bueche/boat_drone/doc/images/boat_scaled_to_accomodate_electronics.jpg

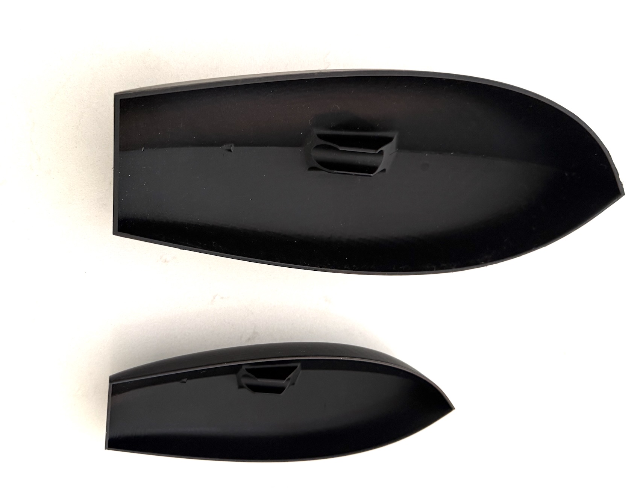
doc/images/boat_scaled_to_accomodate_electronics.jpg
