bueche/boat_drone/doc/images/esp32.3pack.jpg

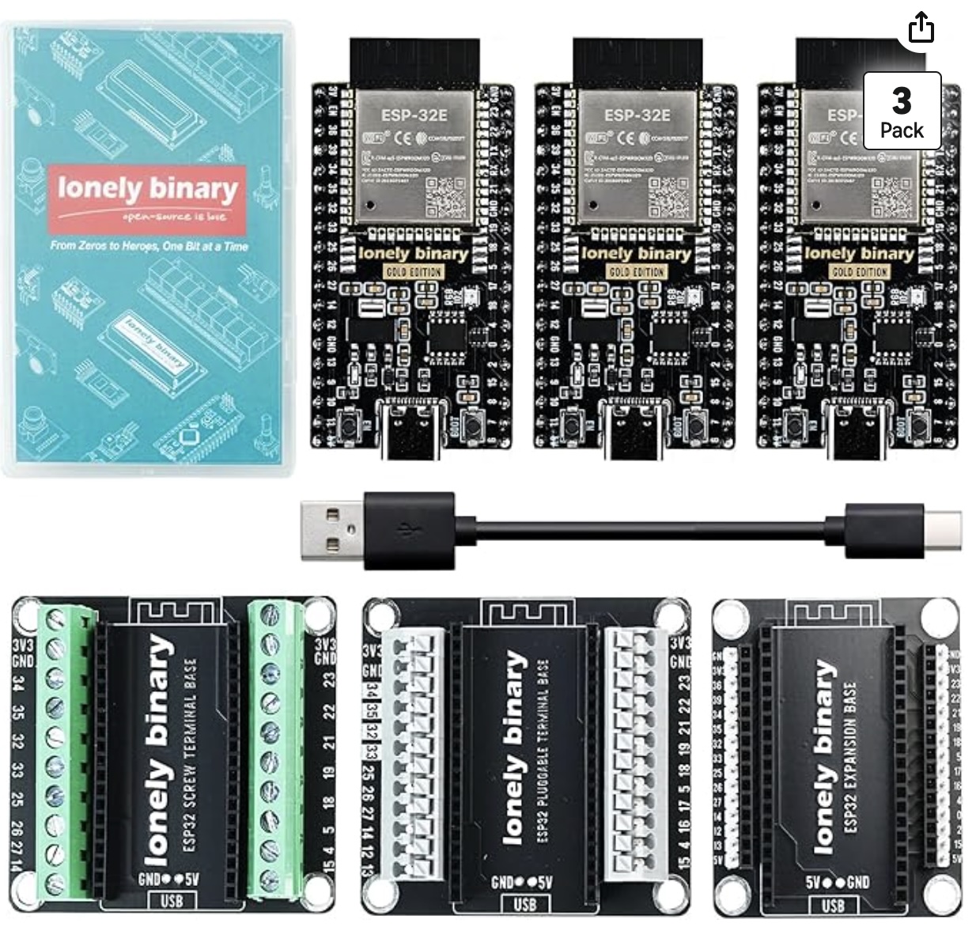
doc/images/esp32.3pack.jpg
