bueche/boat_drone/doc/images/mounting-motor.jpeg

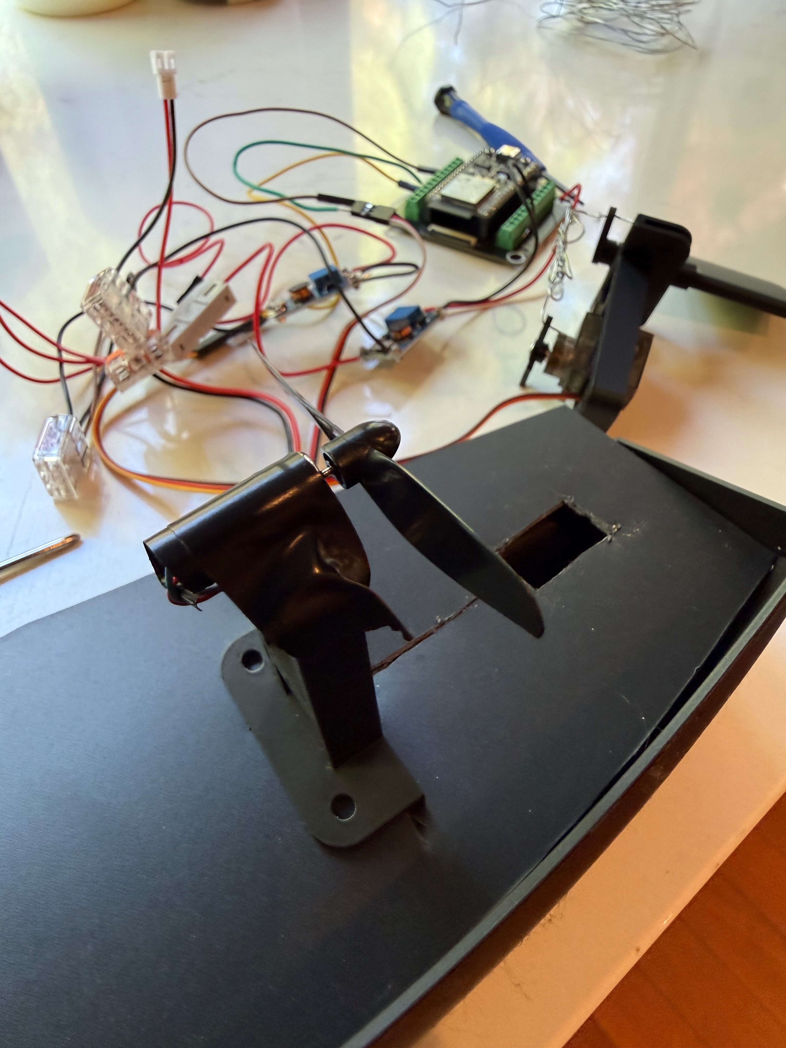
doc/images/mounting-motor.jpeg
