bueche/boat_drone/doc/images/multi-meter1.jpeg

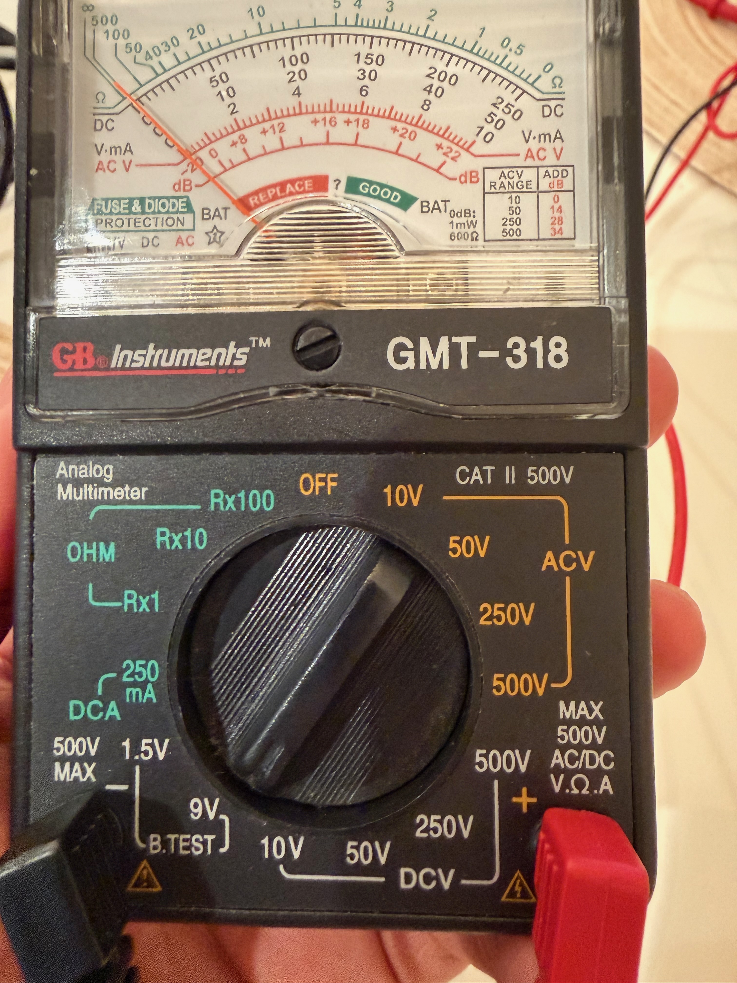
doc/images/multi-meter1.jpeg
