bueche/boat_drone/doc/images/servo.jpg

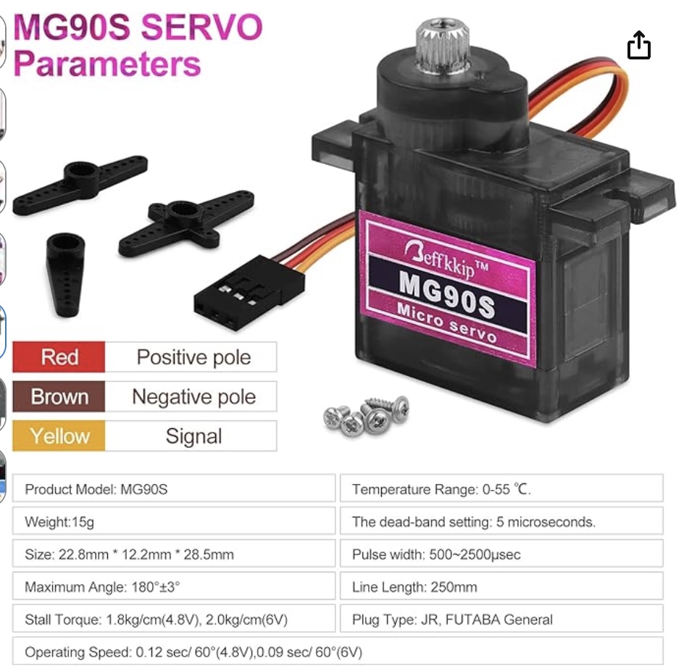
doc/images/servo.jpg
