bueche/boat_drone/doc/images/wp-top-side-glan-mount.jpg

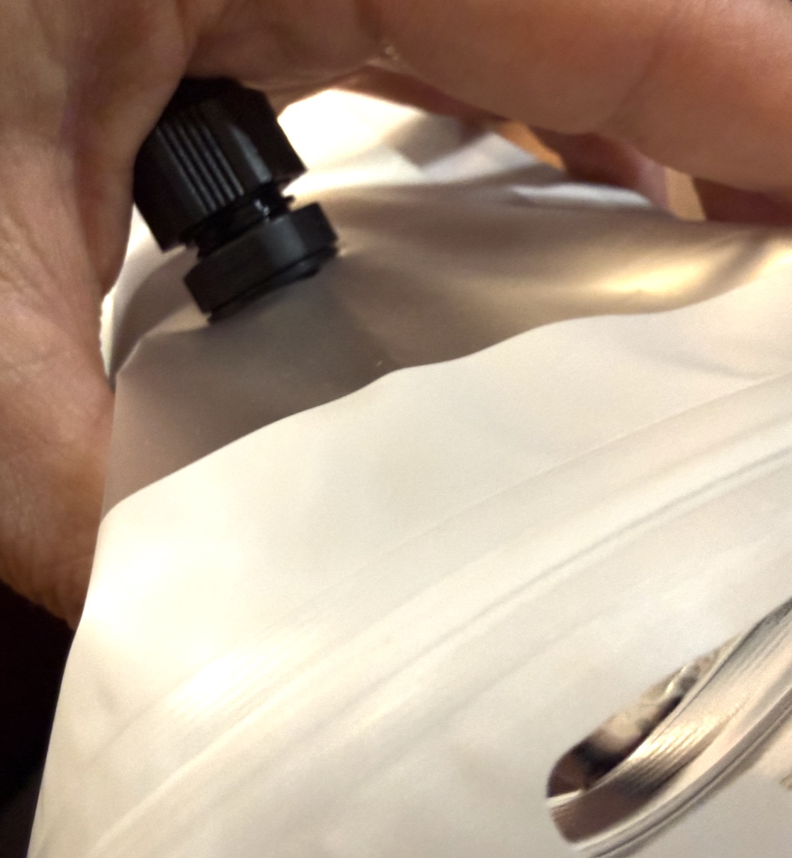
doc/images/wp-top-side-glan-mount.jpg
