bueche/boat_drone/doc/images/weighing-parts.jpeg

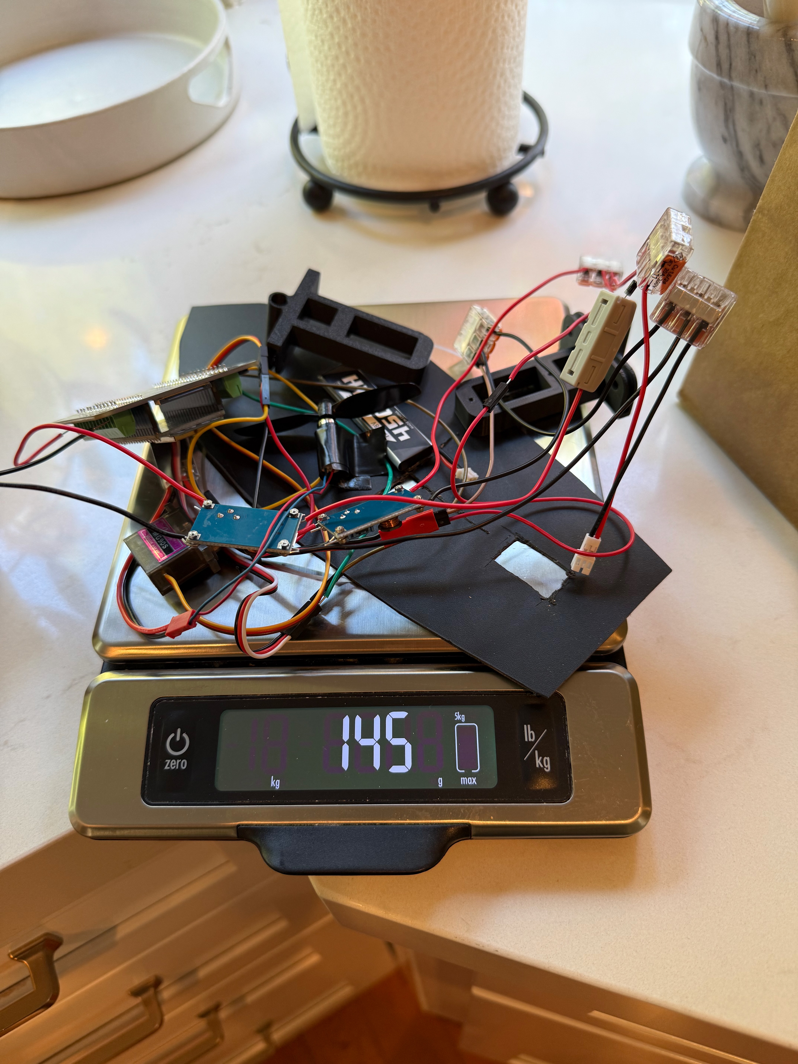
doc/images/weighing-parts.jpeg
