bueche/boat_drone/doc/images/part2-wiring-3.jpeg

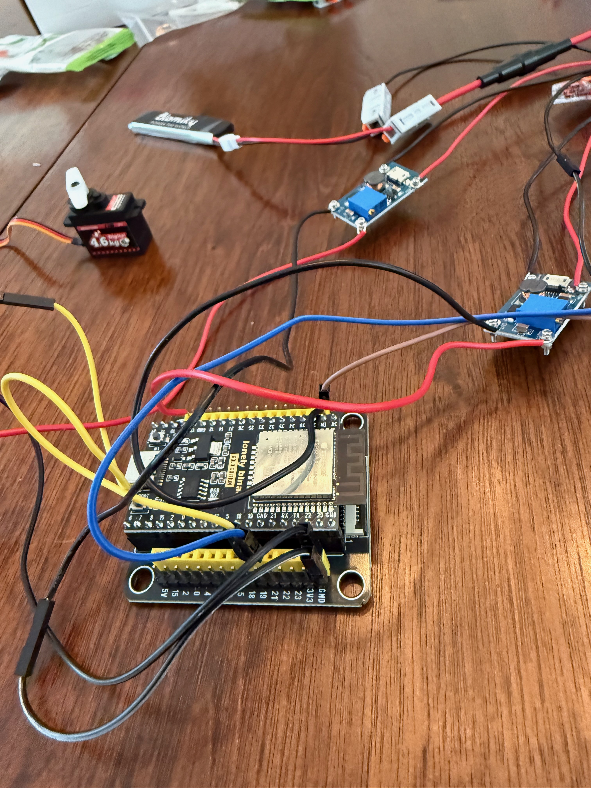
doc/images/part2-wiring-3.jpeg
