bueche/boat_drone/doc/images/part2-wiring-4.jpeg

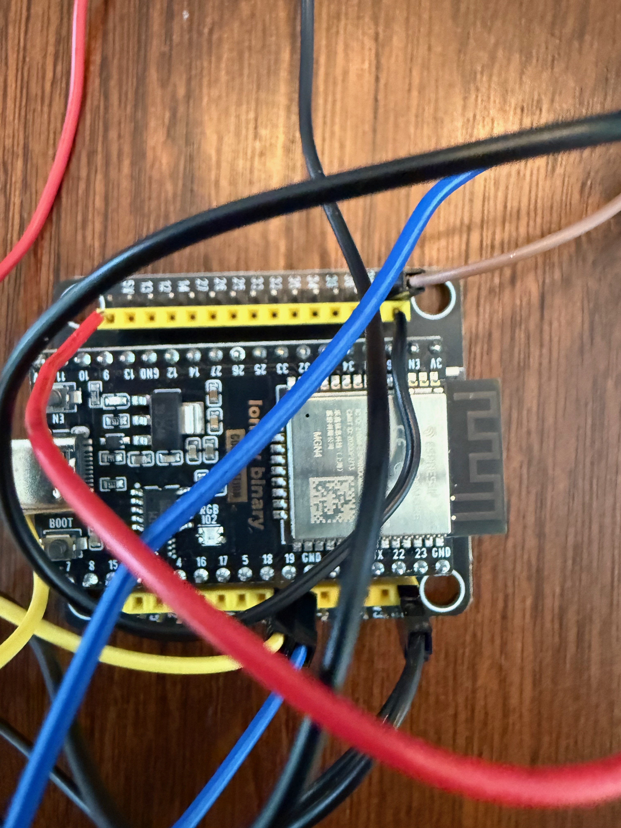
doc/images/part2-wiring-4.jpeg
