bueche/boat_drone/(commit log)

2026-08-28 finished setup and moving on to servo
2026-08-31 basic servo documentation
2026-09-01 http servo
2026-09-04 starting on battery and dc motor
2026-09-12 initial dc motor and batter documentation
2026-09-24 battery-powers-all documentation part 1
2026-09-25 final changes for v1 of the battery-runs-all
2026-09-26 propelling the boat documentation
2026-09-26 change photo for propelling
2026-09-28 extra capacitor for esp32
